LuciusKrieg/KiCad_GOST_Libs/clock_board_alpha_v2_0.kicad_pcb

## KiCad design clock_board_alpha_v2_0.kicad_pcb (2025-07-01)

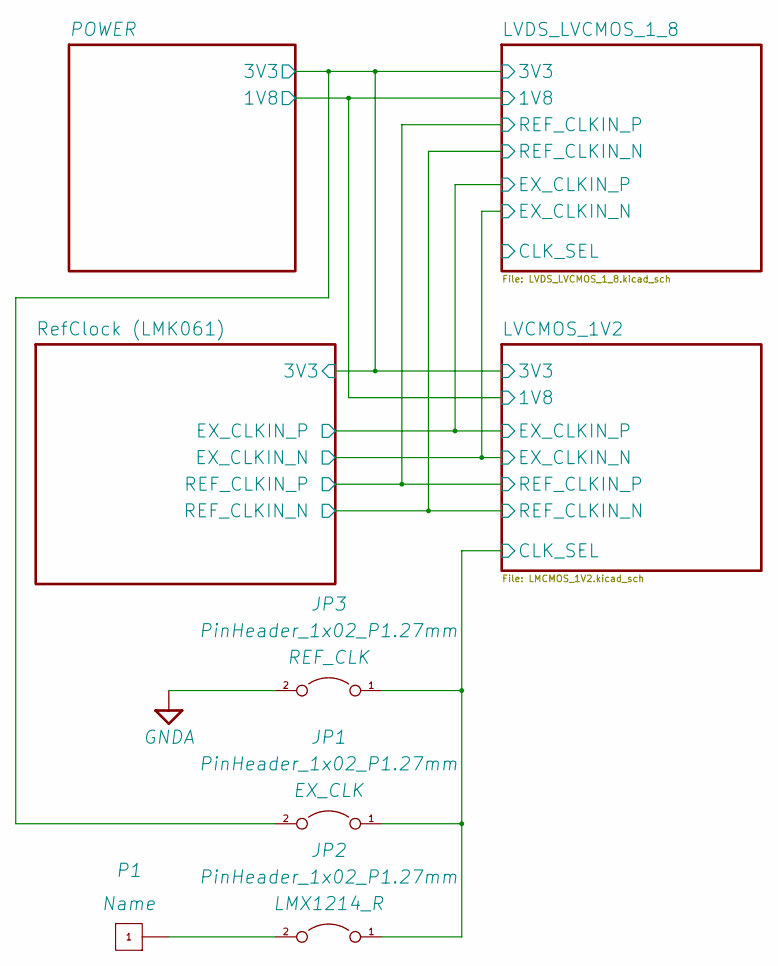
[picture p1: schematic clock_board_alpha_v2_0.kicad_sch]

Parts:
JP1, JP2, JP3: PinHeader_1x02_P1.27mm; PinHeader_1x02_P1.27mm_Vertical
P1: PinHeader_1x01_P1.00mm_Vertical

Connections:
/LVCMOS_1V2/CLK_SEL: JP1.1 (A), JP2.1 (A), JP3.1 (A); also elsewhere on the board
GNDA: JP3.2 (B); also elsewhere on the board
unnamed: JP2.2 (B), P1.1
VDD_3V3: JP1.2 (B); also elsewhere on the board

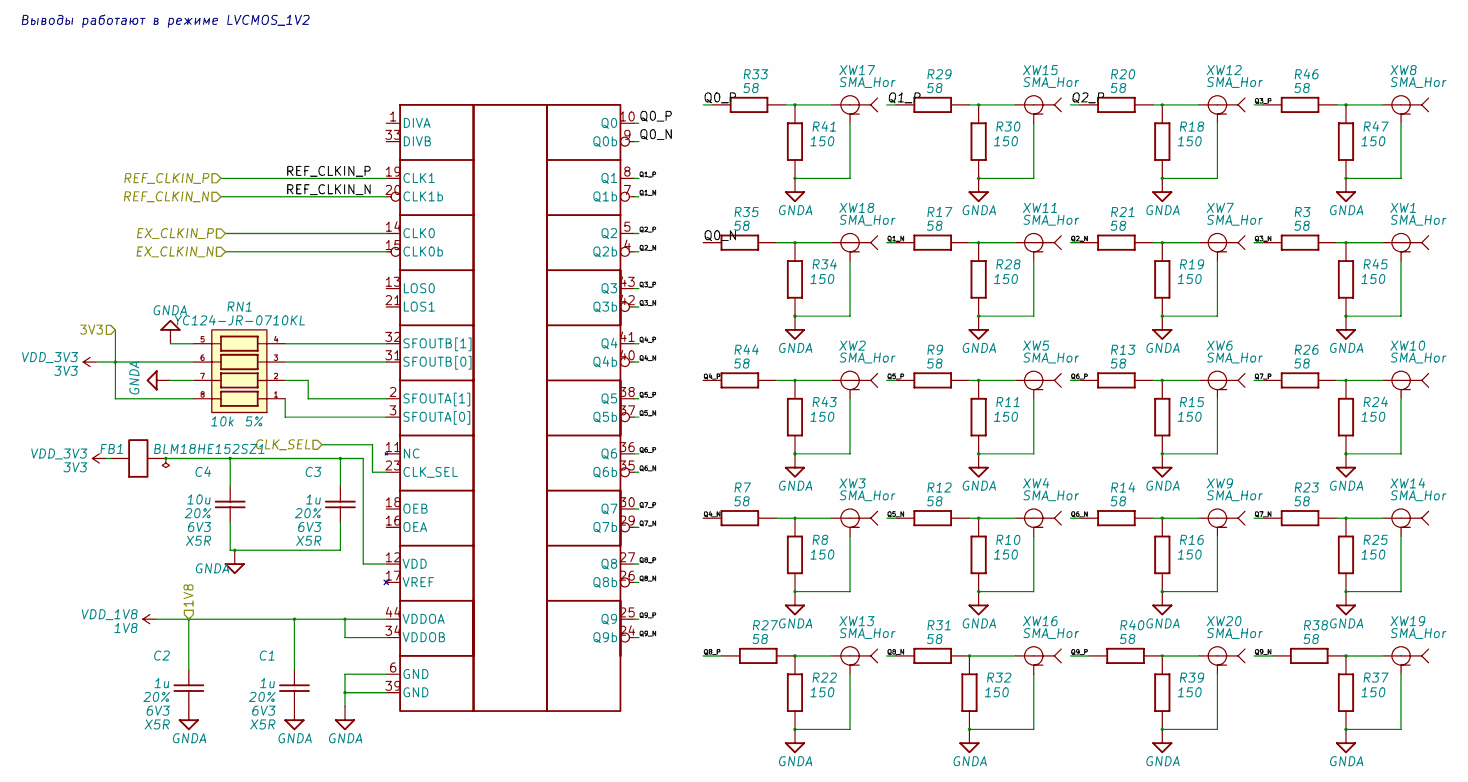
[picture p2: schematic LMCMOS_1V2.kicad_sch]

Parts:
C1, C2, C3: GRM033R60J105MEA; C_0201_0603Metric; Tolerance 20%
C4: CL05A106MQ5NUNC; C_0402_1005Metric; Tolerance 20%
FB1: BLM18HE152SZ1; L_0603_1608Metric
R3, R7, R8, R9, R10, R11, R12, R13, R14, R15, R16, R17, R18, R19, R20, R21, R22, R23, R24, R25, R26, R27, R28, R29, R30, R31, R32, R33, R34, R35, R37, R38, R39, R40, R41, R43, R44, R45, R46, R47: TNPR020150R0FEED; R_0201_0603Metric; Tolerance 1%
RN1: YC124-JR-0710KL; R_Array_Convex_4x0402; Tolerance 5%
SI53302: TQFN-44-1EP_7x7mm_P0.5mm_EP4.7x4.7mm
XW1, XW2, XW3, XW4, XW5, XW6, XW7, XW8, XW9, XW10, XW11, XW12, XW13, XW14, XW15, XW16, XW17, XW18, XW19, XW20: SMA_Amphenol_901-143_Horizontal

Connections:
/LVCMOS_1V2/CLK_SEL: SI53302.23 (CLK_SEL); also elsewhere on the board
/LVCMOS_1V2/Q0_N: R35.2, SI53302.9 (Q0b)
/LVCMOS_1V2/Q0_P: R33.2, SI53302.10 (Q0)
/LVCMOS_1V2/Q1_N: R17.2, SI53302.7 (Q1b)
/LVCMOS_1V2/Q1_P: R29.2, SI53302.8 (Q1)
/LVCMOS_1V2/Q2_N: R21.2, SI53302.4 (Q2b)
/LVCMOS_1V2/Q2_P: R20.2, SI53302.5 (Q2)
/LVCMOS_1V2/Q3_N: R3.2, SI53302.42 (Q3b)
/LVCMOS_1V2/Q3_P: R46.2, SI53302.43 (Q3)
/LVCMOS_1V2/Q4_N: R7.2, SI53302.40 (Q4b)
/LVCMOS_1V2/Q4_P: R44.2, SI53302.41 (Q4)
/LVCMOS_1V2/Q5_N: R12.2, SI53302.37 (Q5b)
/LVCMOS_1V2/Q5_P: R9.2, SI53302.38 (Q5)
/LVCMOS_1V2/Q6_N: R14.2, SI53302.35 (Q6b)
/LVCMOS_1V2/Q6_P: R13.2, SI53302.36 (Q6)
/LVCMOS_1V2/Q7_N: R23.2, SI53302.29 (Q7b)
/LVCMOS_1V2/Q7_P: R26.2, SI53302.30 (Q7)
/LVCMOS_1V2/Q8_N: R31.2, SI53302.26 (Q8b)
/LVCMOS_1V2/Q8_P: R27.2, SI53302.27 (Q8)
/LVCMOS_1V2/Q9_N: R38.2, SI53302.24 (Q9b)
/LVCMOS_1V2/Q9_P: R40.2, SI53302.25 (Q9)
/LVCMOS_1V2/REF_CLKIN_N: SI53302.20 (CLK1b); also elsewhere on the board
/LVCMOS_1V2/REF_CLKIN_P: SI53302.19 (CLK1); also elsewhere on the board
/RefClock (LMK061)/EX_CLKIN_N: SI53302.15 (CLK0b); also elsewhere on the board
/RefClock (LMK061)/EX_CLKIN_P: SI53302.14 (CLK0); also elsewhere on the board
GNDA: C1.2, C2.2, C3.2, C4.2, R8.1, R10.1, R11.1, R15.1, R16.1, R18.1, R19.1, R22.1, R24.1, R25.1, R28.1, R30.1, R32.1, R34.1, R37.1, R39.1, R41.1, R43.1, R45.1, R47.1, RN1.5, RN1.7, SI53302.6 (GND), SI53302.39 (GND), XW1.2, XW2.2, XW3.2, XW4.2, XW5.2, XW6.2, XW7.2, XW8.2, XW9.2, XW10.2, XW11.2, XW12.2, XW13.2, XW14.2, XW15.2, XW16.2, XW17.2, XW18.2, XW19.2, XW20.2; also elsewhere on the board
unnamed: R3.1, R45.2, XW1.1
unnamed: R7.1, R8.2, XW3.1
unnamed: R10.2, R12.1, XW4.1
unnamed: R9.1, R11.2, XW5.1
unnamed: R13.1, R15.2, XW6.1
unnamed: R14.1, R16.2, XW9.1
unnamed: R17.1, R28.2, XW11.1
unnamed: R18.2, R20.1, XW12.1
unnamed: R19.2, R21.1, XW7.1
unnamed: R22.2, R27.1, XW13.1
unnamed: R23.1, R25.2, XW14.1
unnamed: R24.2, R26.1, XW10.1
unnamed: R29.1, R30.2, XW15.1
unnamed: R31.1, R32.2, XW16.1
unnamed: R33.1, R41.2, XW17.1
unnamed: R34.2, R35.1, XW18.1
unnamed: R37.2, R38.1, XW19.1
unnamed: R39.2, R40.1, XW20.1
unnamed: R43.2, R44.1, XW2.1
unnamed: R46.1, R47.2, XW8.1
unnamed: RN1.1, SI53302.3 (SFOUTA[0])
unnamed: RN1.2, SI53302.2 (SFOUTA[1])
unnamed: RN1.3, SI53302.31 (SFOUTB[0])
unnamed: RN1.4, SI53302.32 (SFOUTB[1])
unnamed: C3.1, C4.1, FB1.2, SI53302.12 (VDD)
VDD_1V8: C1.1, C2.1, SI53302.34 (VDDOB), SI53302.44 (VDDOA); also elsewhere on the board
VDD_3V3: FB1.1, RN1.6, RN1.8; also elsewhere on the board

Notes on the sheet:
Выводы работают в режиме LVСMOS_1V2

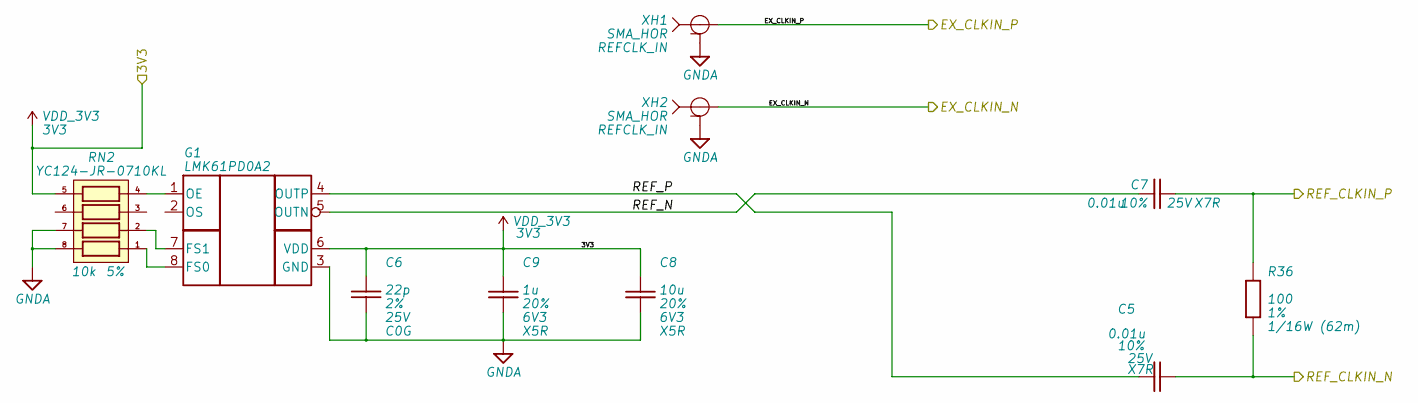
[picture p3: schematic RefClock.kicad_sch]

Parts:
C5, C7: GRM033R71E103KE; C_0201_0603Metric; Tolerance 10%
C6: GJM0335C1E220GB; C_0201_0603Metric; Tolerance 2%
C8: CL05A106MQ5NUNC; C_0402_1005Metric; Tolerance 20%
C9: GRM033R60J105MEA; C_0201_0603Metric; Tolerance 20%
G1: LMK61PD0A2; QFM-8-SIA
R36: RC0402FR-07100RL; R_0402_1005Metric; Tolerance 1%
RN2: YC124-JR-0710KL; R_Array_Convex_4x0402; Tolerance 5%
XH1, XH2: SMA_HOR; SMA_Amphenol_901-144_Vertical

Connections:
/LVCMOS_1V2/REF_CLKIN_N: C5.2, R36.1; also elsewhere on the board
/LVCMOS_1V2/REF_CLKIN_P: C7.2, R36.2; also elsewhere on the board
/RefClock (LMK061)/EX_CLKIN_N: XH2.1; also elsewhere on the board
/RefClock (LMK061)/EX_CLKIN_P: XH1.1; also elsewhere on the board
/RefClock (LMK061)/REF_N: C7.1, G1.5 (OUTN)
/RefClock (LMK061)/REF_P: C5.1, G1.4 (OUTP)
GNDA: C6.1, C8.2, C9.2, G1.3 (GND), RN2.7, RN2.8, XH1.2, XH2.2; also elsewhere on the board
unnamed: G1.8 (FS0), RN2.1
unnamed: G1.7 (FS1), RN2.2
unnamed: G1.1 (OE), RN2.4
VDD_3V3: C6.2, C8.1, C9.1, G1.6 (VDD), RN2.5; also elsewhere on the board

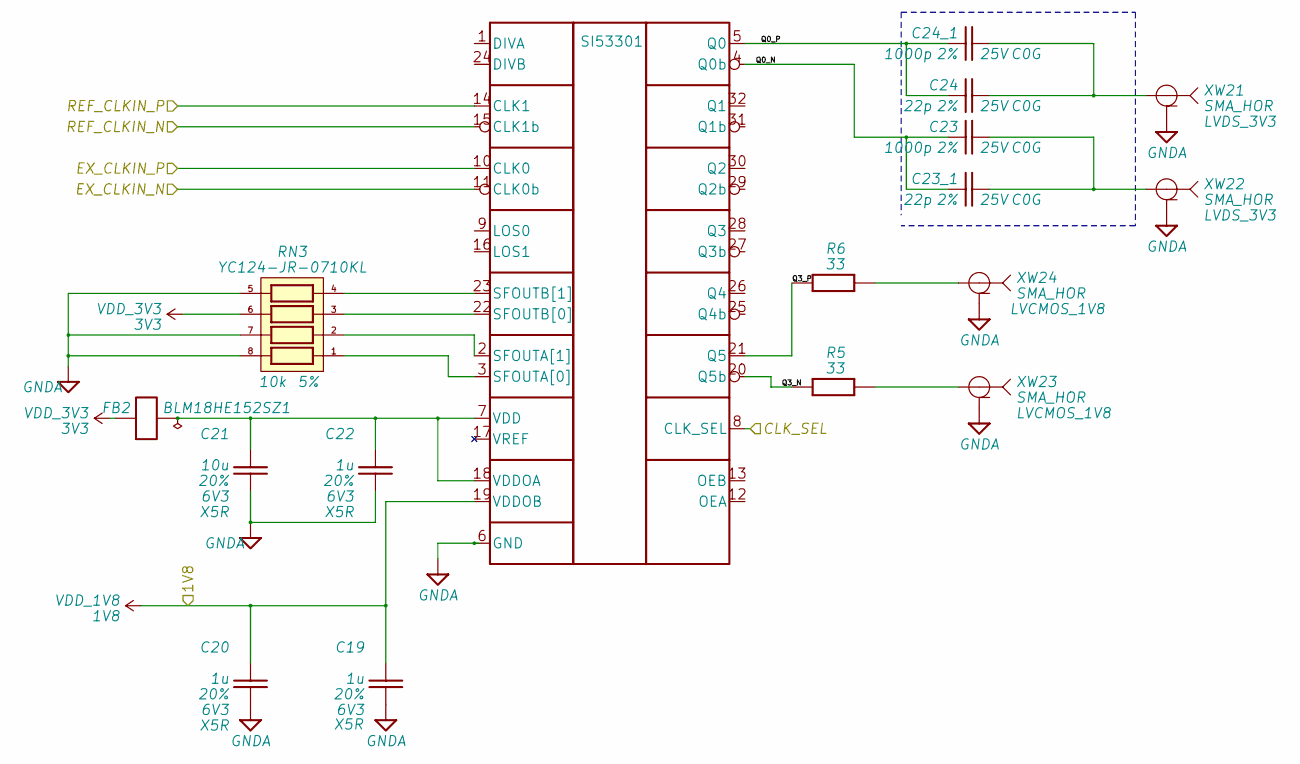
[picture p4: schematic LVDS_LVCMOS_1_8.kicad_sch]

Parts:
C19, C20, C22: GRM033R60J105MEA; C_0201_0603Metric; Tolerance 20%
C21: CL05A106MQ5NUNC; C_0402_1005Metric; Tolerance 20%
C23, C24_1: GRM0335C1E102GA; C_0201_0603Metric; Tolerance 2%
C23_1, C24: GJM0335C1E220GB; C_0201_0603Metric; Tolerance 2%
FB2: BLM18HE152SZ1; L_0603_1608Metric
R5, R6: TNPR020150R0FEED; R_0201_0603Metric; Tolerance 1%
RN3: YC124-JR-0710KL; R_Array_Convex_4x0402; Tolerance 5%
SI53301: QFN-32-1EP_5x5mm_P0.5mm_EP3.1x3.1mm
XW21, XW22, XW23, XW24: SMA_HOR; SMA_Amphenol_901-143_Horizontal

Connections:
/LVCMOS_1V2/REF_CLKIN_N: SI53301.15 (CLK1b); also elsewhere on the board
/LVCMOS_1V2/REF_CLKIN_P: SI53301.14 (CLK1); also elsewhere on the board
/LVDS_LVCMOS_1_8/CLK_SEL: SI53301.8 (CLK_SEL)
/LVDS_LVCMOS_1_8/Q0_N: C23.1, C23_1.1, SI53301.4 (Q0b)
/LVDS_LVCMOS_1_8/Q0_P: C24.1, C24_1.1, SI53301.5 (Q0)
/LVDS_LVCMOS_1_8/Q3_N: R5.2, SI53301.20 (Q5b)
/LVDS_LVCMOS_1_8/Q3_P: R6.2, SI53301.21 (Q5)
/RefClock (LMK061)/EX_CLKIN_N: SI53301.11 (CLK0b); also elsewhere on the board
/RefClock (LMK061)/EX_CLKIN_P: SI53301.10 (CLK0); also elsewhere on the board
GNDA: C19.2, C20.2, C21.2, C22.2, RN3.5, RN3.7, RN3.8, SI53301.6 (GND), XW21.2, XW22.2, XW23.2, XW24.2; also elsewhere on the board
unnamed: C23.2, C23_1.2, XW22.1
unnamed: C24.2, C24_1.2, XW21.1
unnamed: R5.1, XW23.1
unnamed: R6.1, XW24.1
unnamed: RN3.1, SI53301.3 (SFOUTA[0])
unnamed: RN3.2, SI53301.2 (SFOUTA[1])
unnamed: RN3.3, SI53301.22 (SFOUTB[0])
unnamed: RN3.4, SI53301.23 (SFOUTB[1])
unnamed: C21.1, C22.1, FB2.2, SI53301.7 (VDD), SI53301.18 (VDDOA)
VDD_1V8: C19.1, C20.1, SI53301.19 (VDDOB); also elsewhere on the board
VDD_3V3: FB2.1, RN3.6; also elsewhere on the board

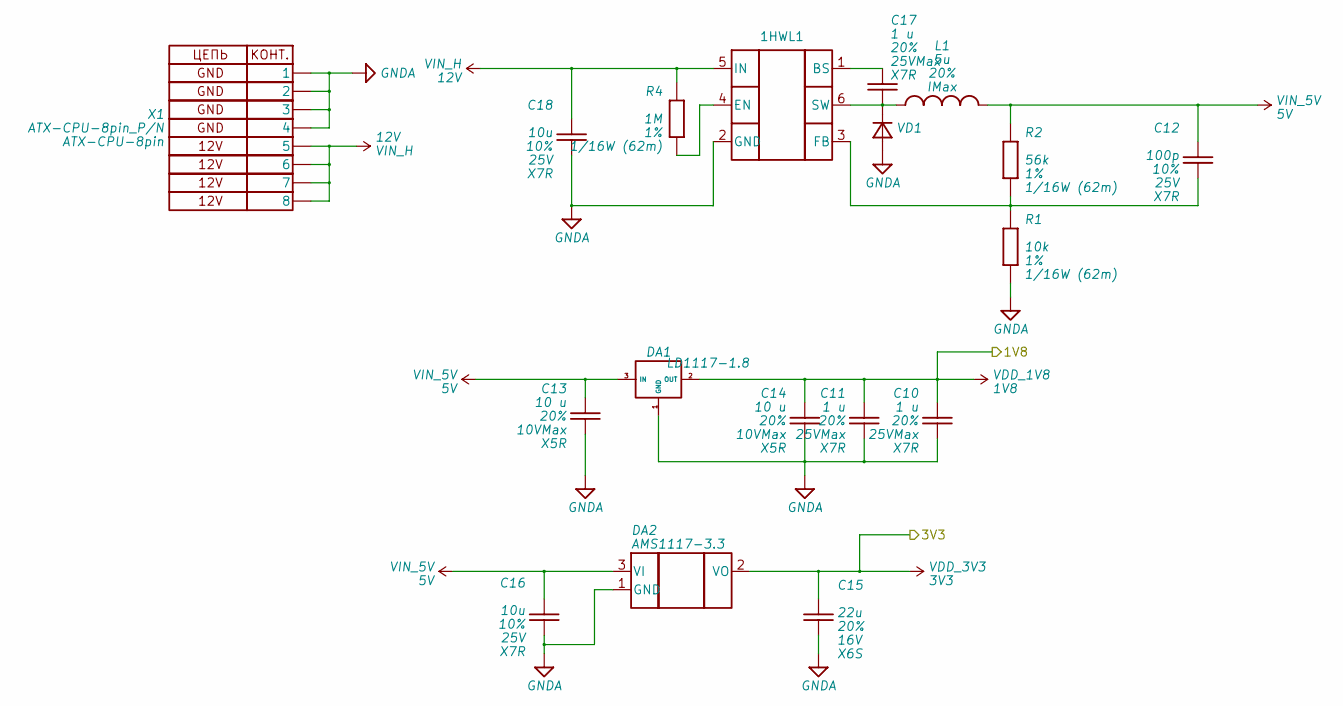
[picture p5: schematic Power.kicad_sch]

Parts:
1HWL1: SOT-23-6
C10, C11, C17: GRM155R61E105KA12D; C_0201_0603Metric; Tolerance 20%
C12, C16, C18: CL21B106KAYQNN; C_0805_2012Metric; Tolerance 10%
C13, C14: CL05A106MP5NUNC; C_0402_1005Metric; Tolerance 20%
C15: GRM21BC81C226ME44; C_0805_2012Metric; Tolerance 20%
DA1: LD1117-1.8; SOT-223-3_TabPin2
DA2: AMS1117-3.3; SOT-223-3_TabPin2
L1: L_Wuerth_HCI-5040; Tolerance 20%
R1: RC0402FR-074K87L; R_0402_1005Metric; Tolerance 1%
R2: RC0402FR-0720KL; R_0402_1005Metric; Tolerance 1%
R4: RC0402FR-0742K2L; R_0402_1005Metric; Tolerance 1%
VD1: D_0402_1005Metric
X1: ATX-CPU-8pin_P/N; Molex_Mini-Fit_Jr_5566-08A_2x04_P4.20mm_Vertical

Connections:
GNDA: 1HWL1.2 (GND), C10.2, C11.2, C13.2, C14.2, C15.2, C16.2, C18.2, DA1.1 (GND), DA2.1 (GND), R1.1, VD1.2 (A), X1.1, X1.2, X1.3, X1.4; also elsewhere on the board
unnamed: 1HWL1.1 (BS), C17.1
unnamed: 1HWL1.4 (EN), R4.1
unnamed: 1HWL1.3 (FB), C12.2, R1.2, R2.1
unnamed: 1HWL1.6 (SW), C17.2, L1.1, VD1.1 (K)
VDD_1V8: C10.1, C11.1, C14.1, DA1.2 (OUT); also elsewhere on the board
VDD_3V3: C15.1, DA2.2 (VO); also elsewhere on the board
VIN_5V: C12.1, C13.1, C16.1, DA1.3 (IN), DA2.3 (VI), L1.2, R2.2
VIN_H: 1HWL1.5 (IN), C18.1, R4.2, X1.5, X1.6, X1.7, X1.8

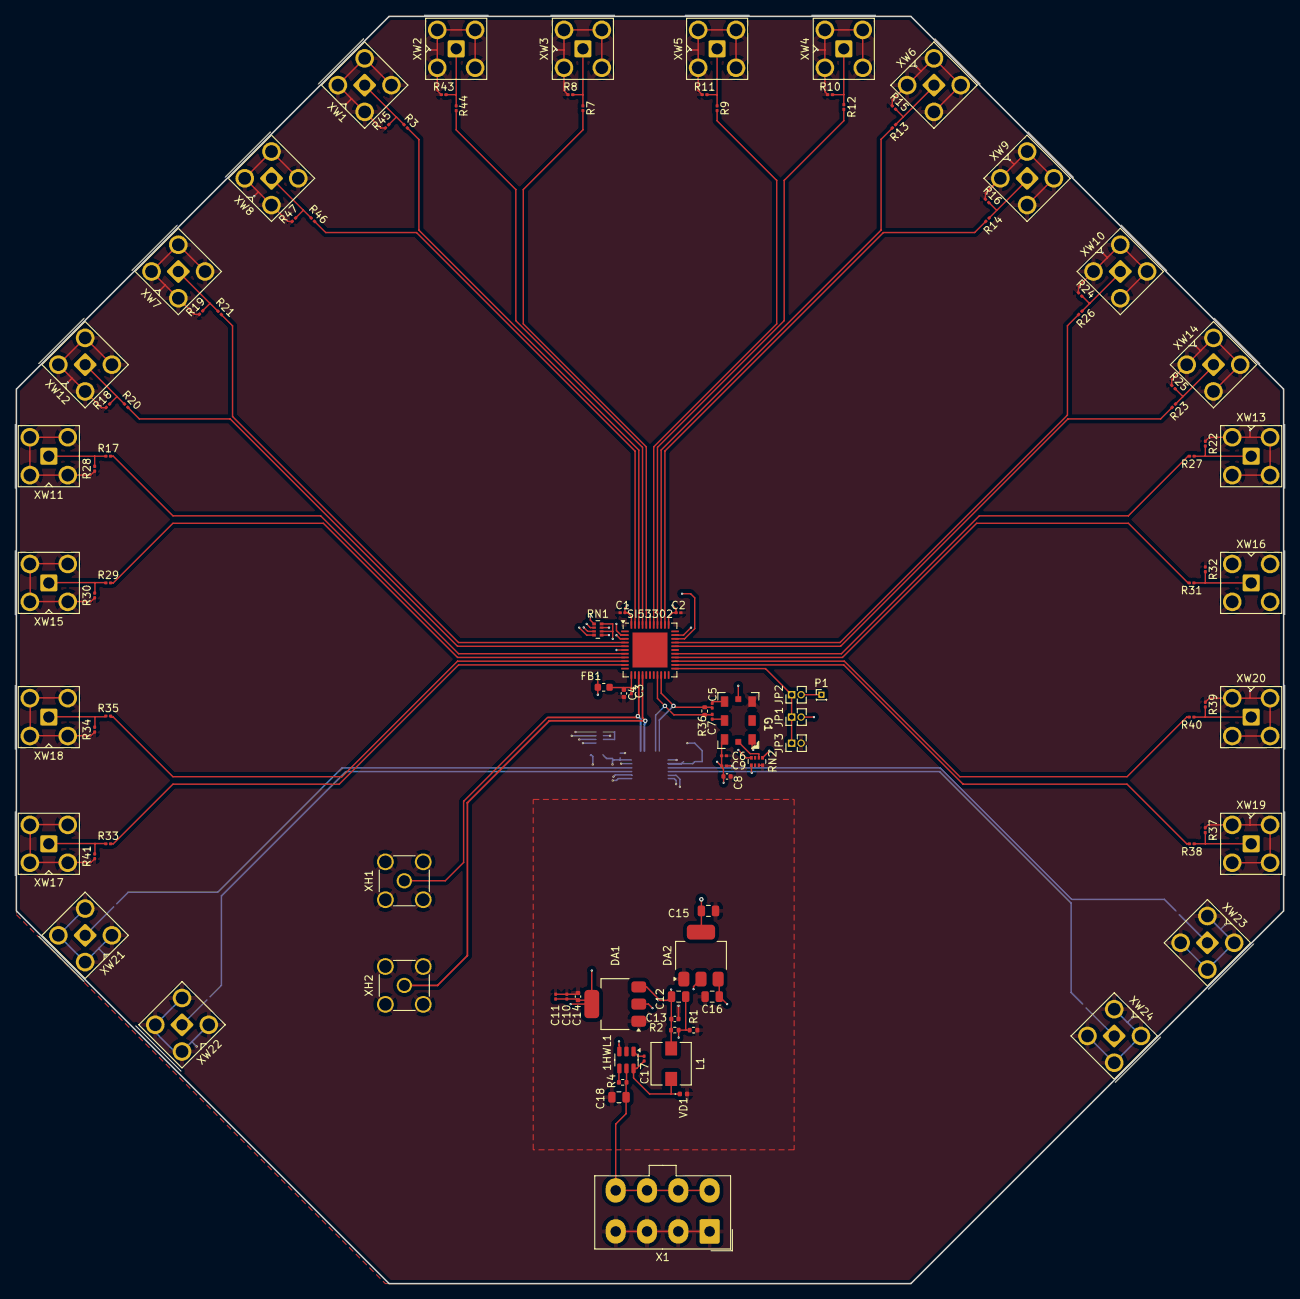
[picture p6: board clock_board_alpha_v2_0.kicad_pcb from above]

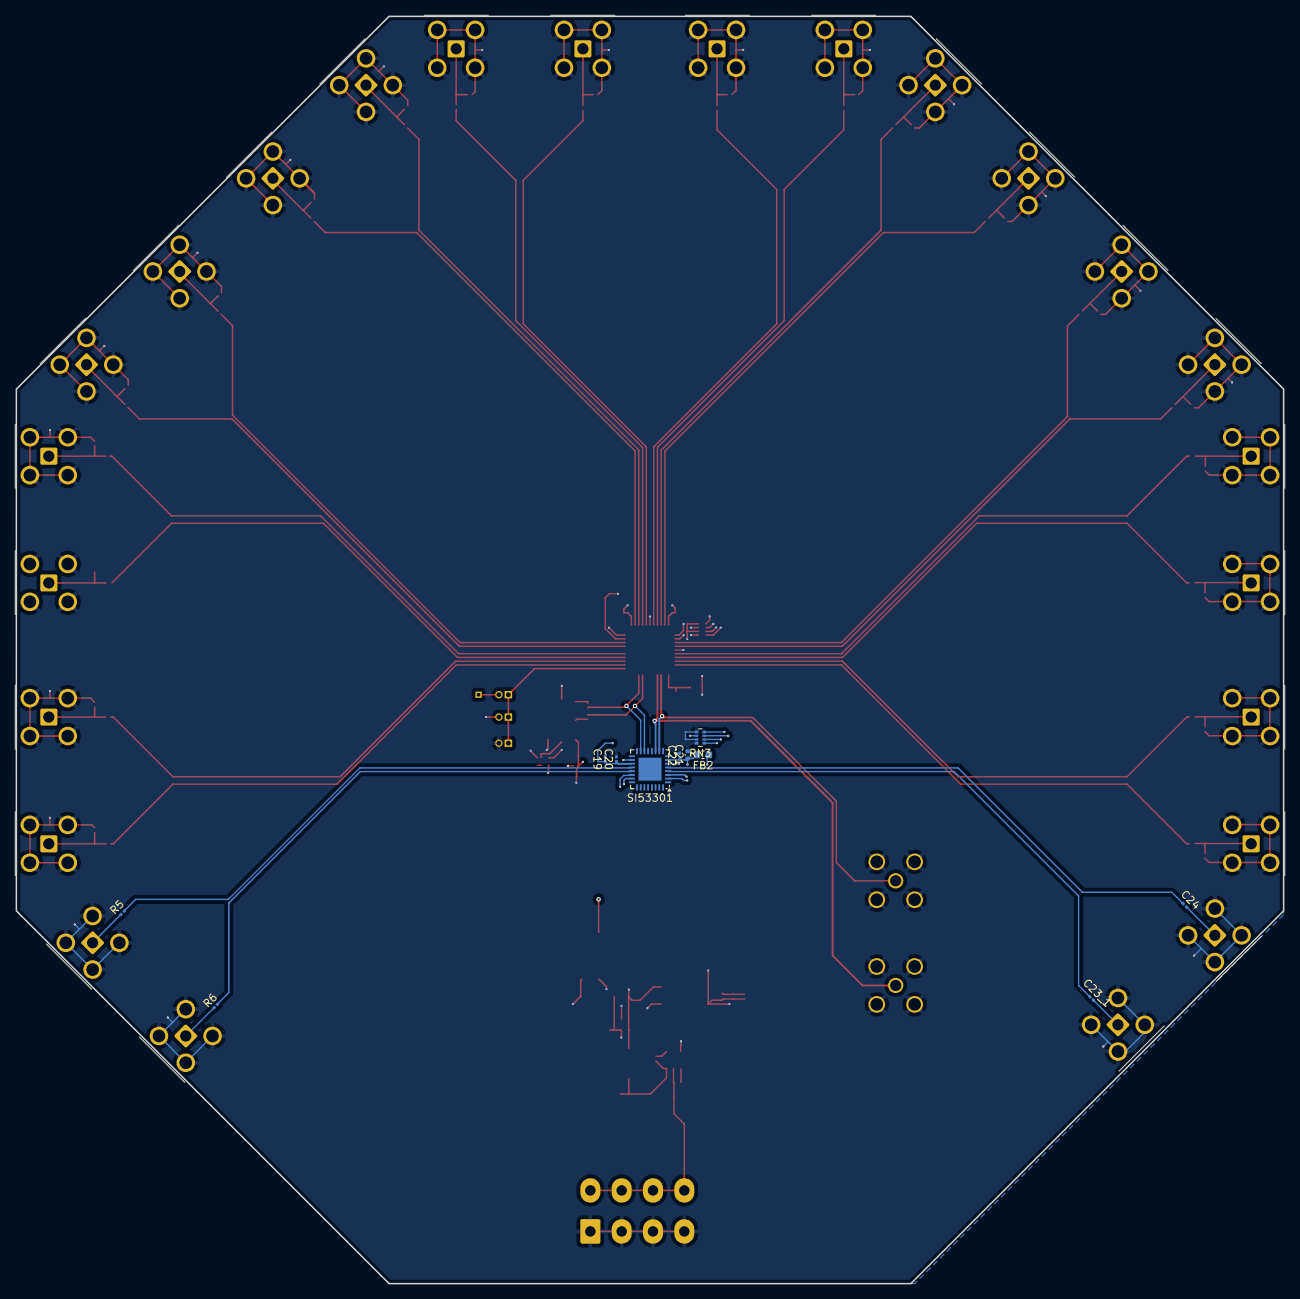
[picture p7: board clock_board_alpha_v2_0.kicad_pcb from below]

Board: 4 copper layers, 170.0 x 170.0 mm, 114 parts (11 on the bottom side), 78 nets.
